eddyem/IR-controller/Documentation_rus/sisupr_short_descr_and_commands_TeX/pic/sisupr_front.jpg

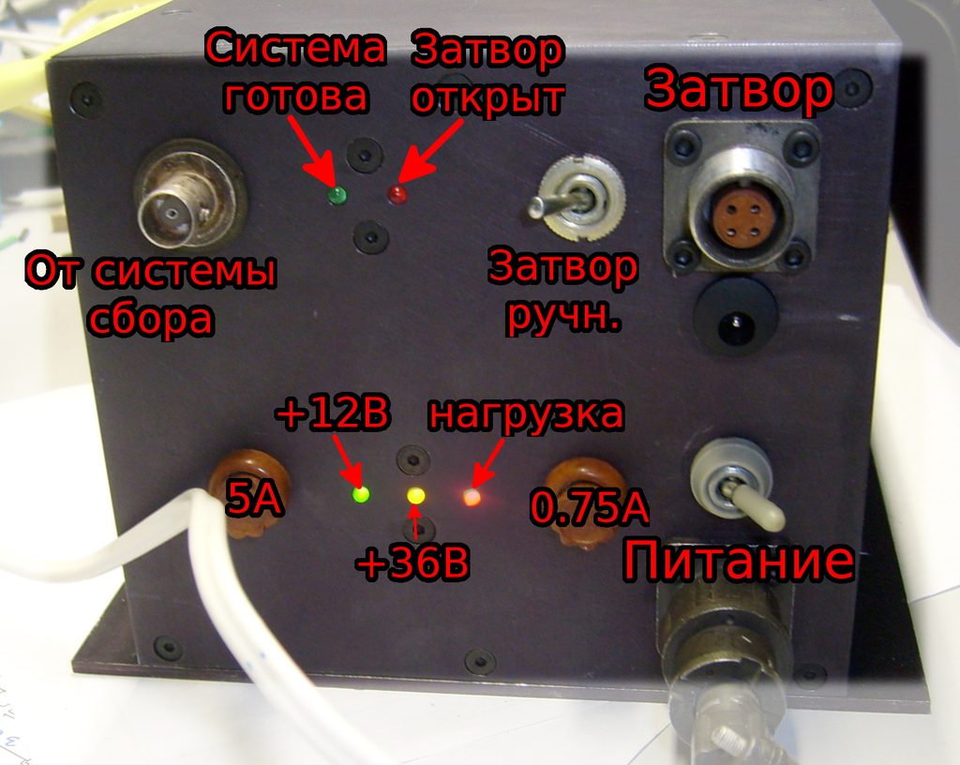
Documentation_rus/sisupr_short_descr_and_commands_TeX/pic/sisupr_front.jpg
