eddyem/IR-controller/README.md

IR-controller
=============

Clone of same project from sourceforge

Don't use files from root directory, they are obsolete!!! 
Current code is in directory with_opencm3.
