eddyem/IR-controller/schematic/ALL.pdf

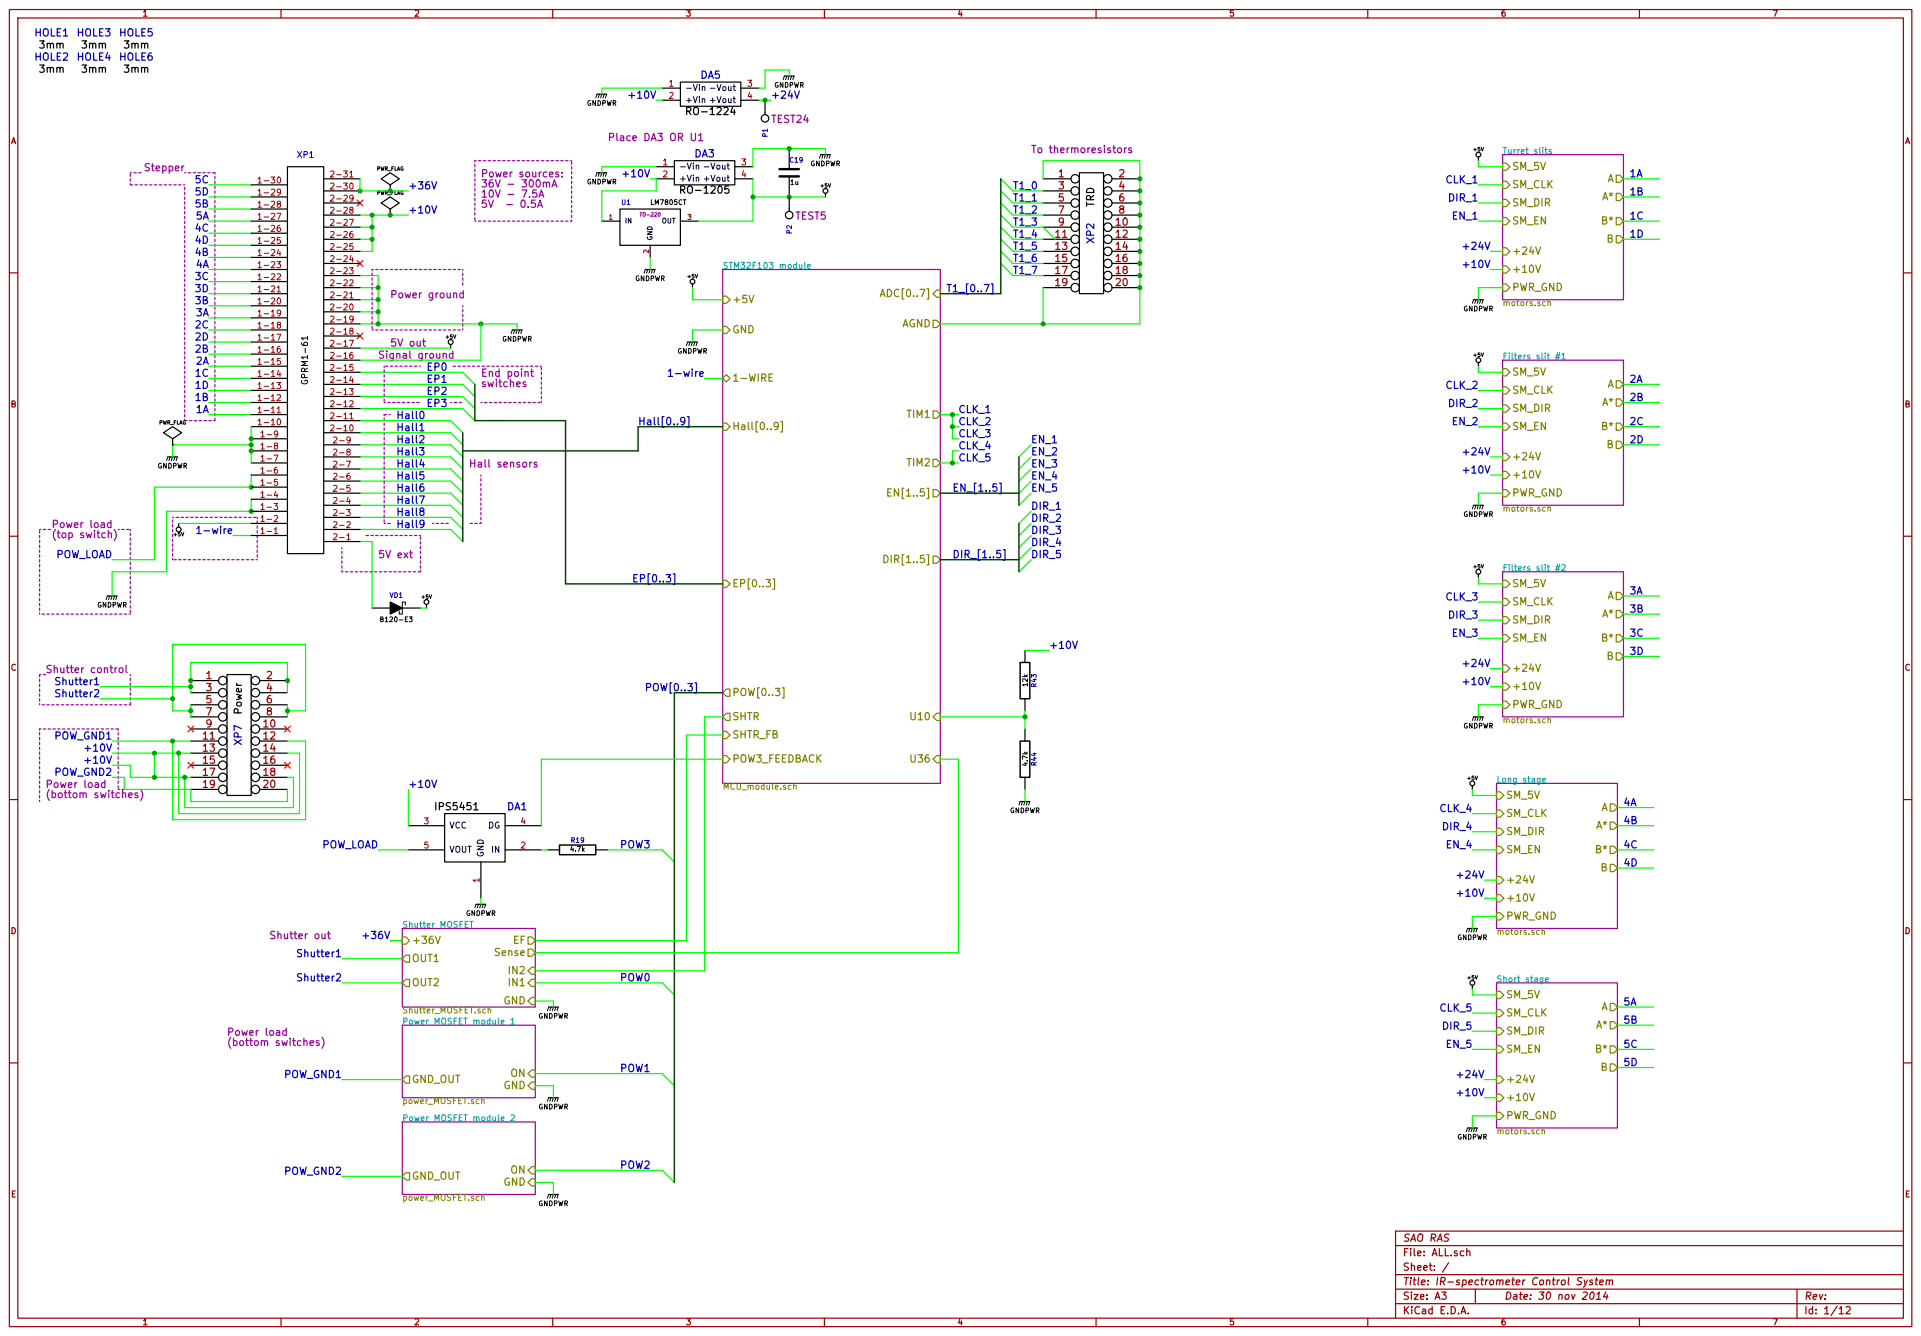
[picture p3: page 1]

Turret slits motors.sch SM_5V

Filters slit #1 motors.sch SM_5V
+5V +10V CLK_2

2-14
2-13

2-10
2-9
2-8
2-7
2-6
2-5
2-4
2-3

13 | | 14
15 | | 16

SAO RAS
File: ALL.sch Sheet: /

Title: IR-spectrometer Control System

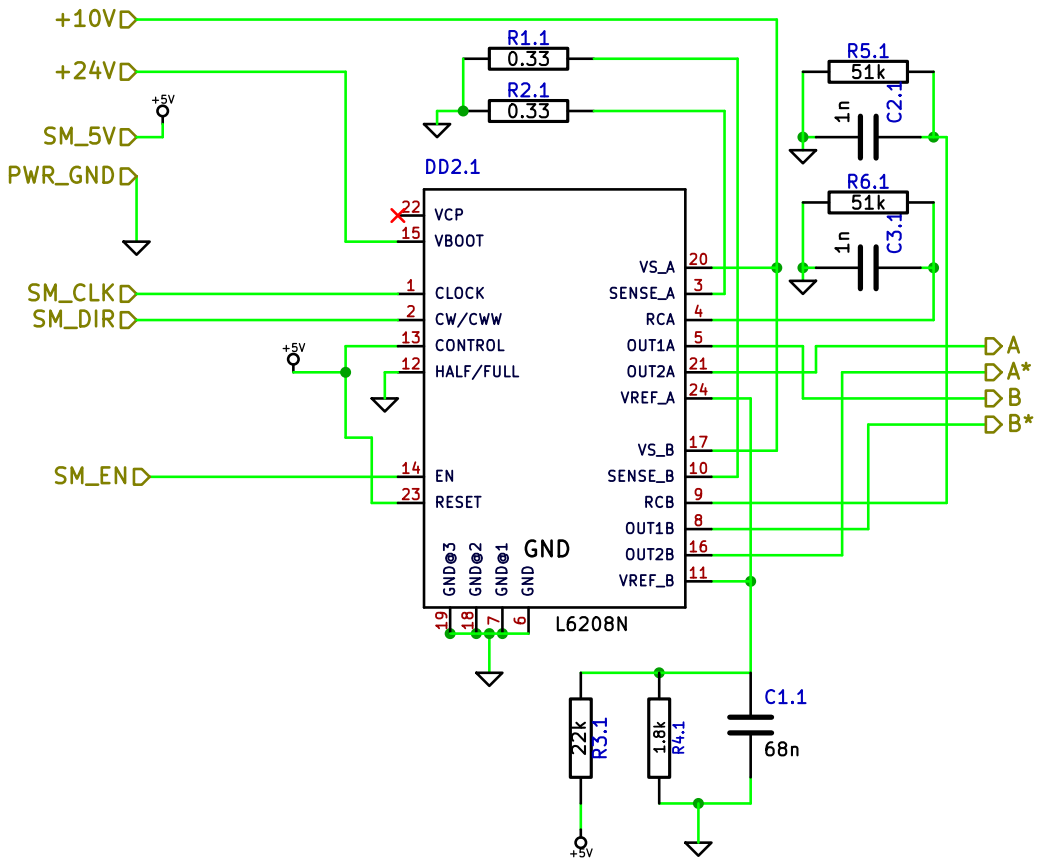
[picture p4: page 2]

7 OUT1B 8 RCB 9 SENSE_B 10 VS_A 20 VREF_B 11 OUT2A 21 HALF/FULL 12 VCP 22 CONTROL 13 RESET 23 EN 14 VREF_A 24 VBOOT 15 OUT2B 16 VS_B 17 GND@2 18 GND@3 19 DD2.1

Title: Stepper motor module File: motors.sch Sheet: /Turret slits/

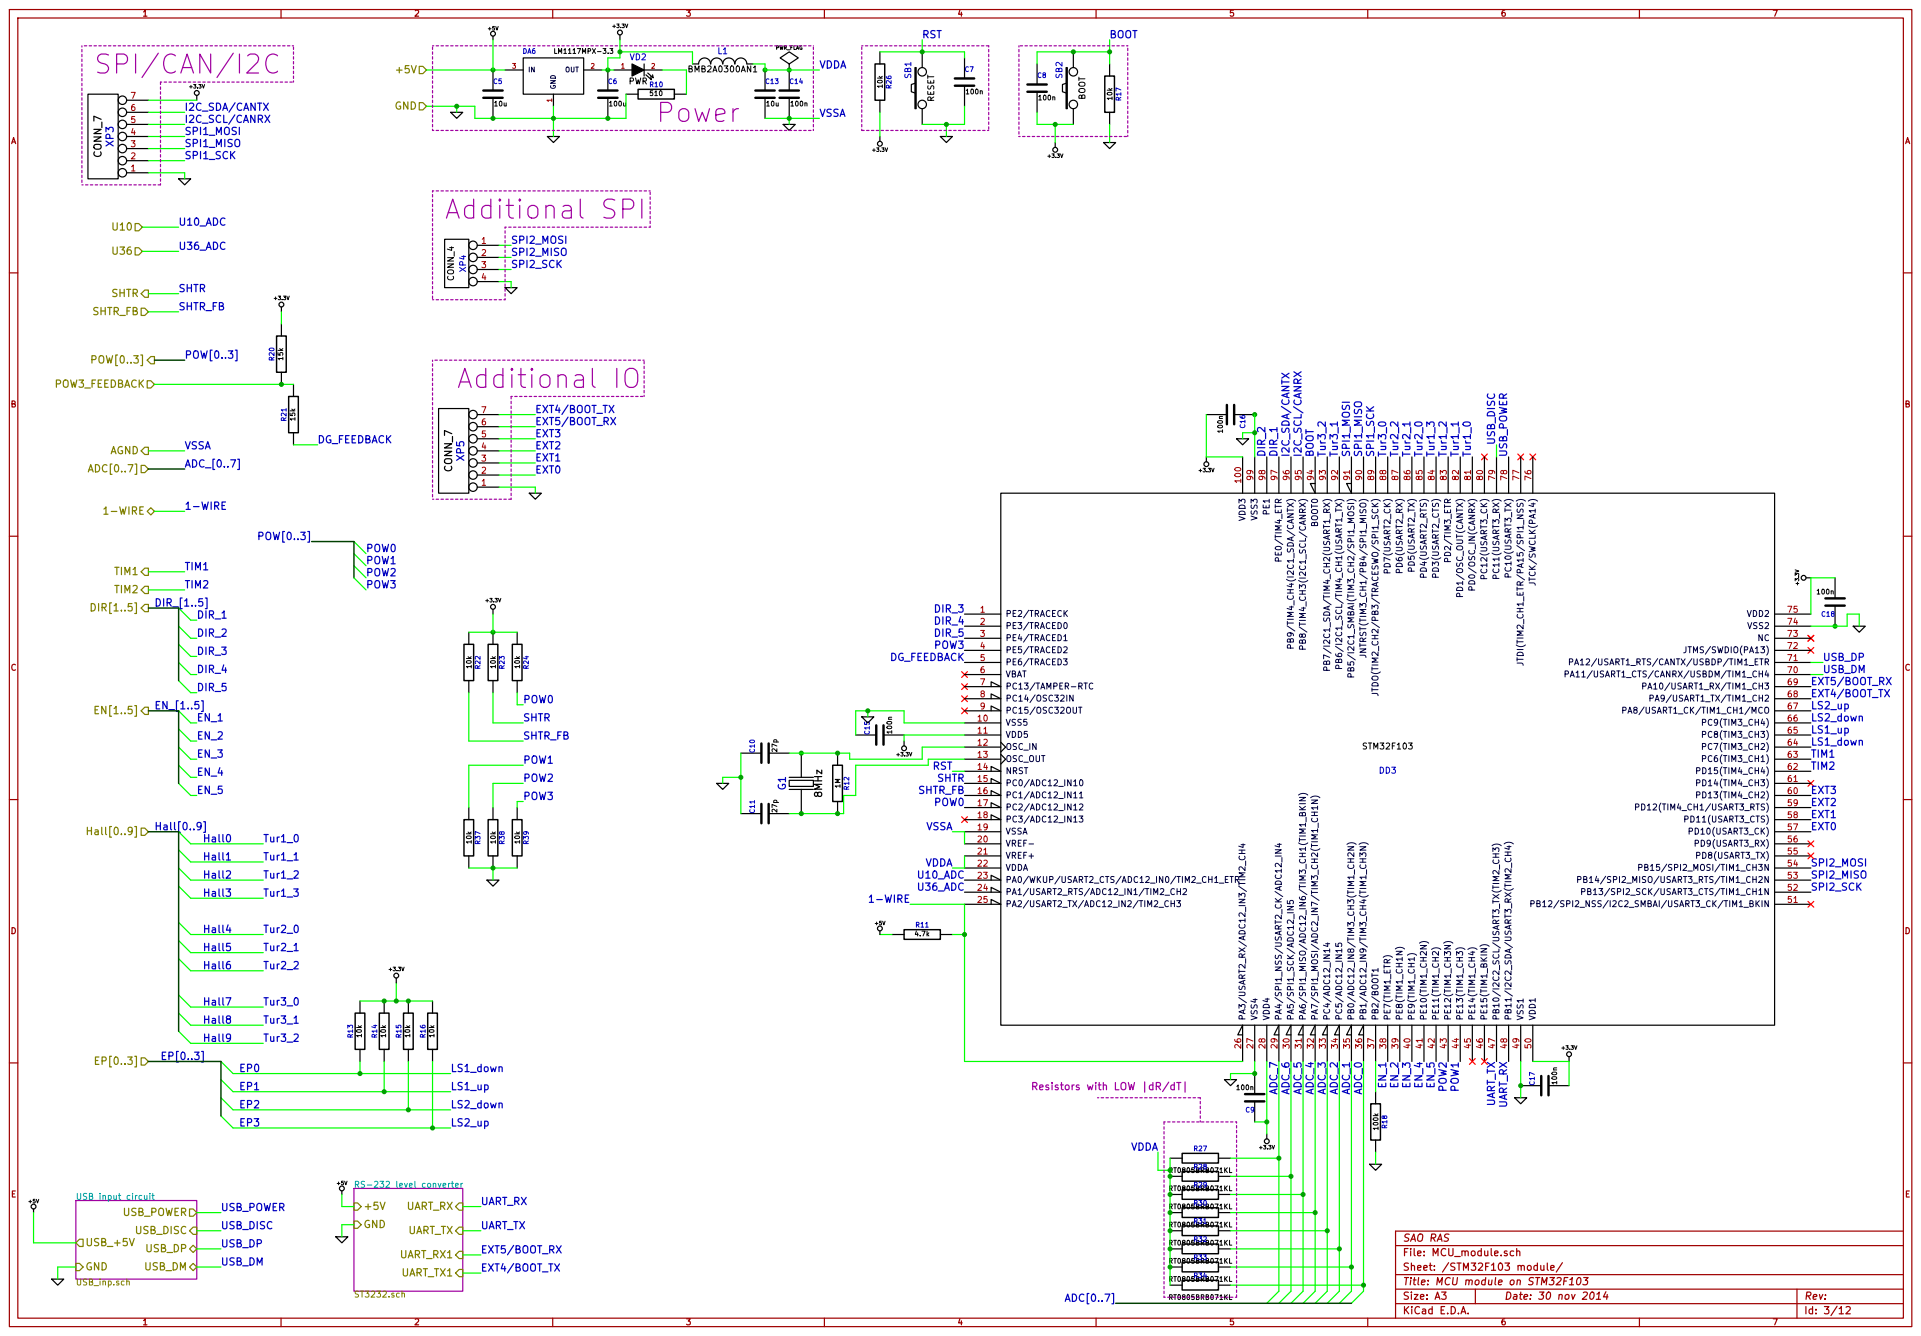
[picture p5: page 3]

RS-232 level converter ST3232.sch GND

SAO RAS
File: MCU_module.sch
Sheet: /STM32F103 module/
Title: MCU module on STM32F103

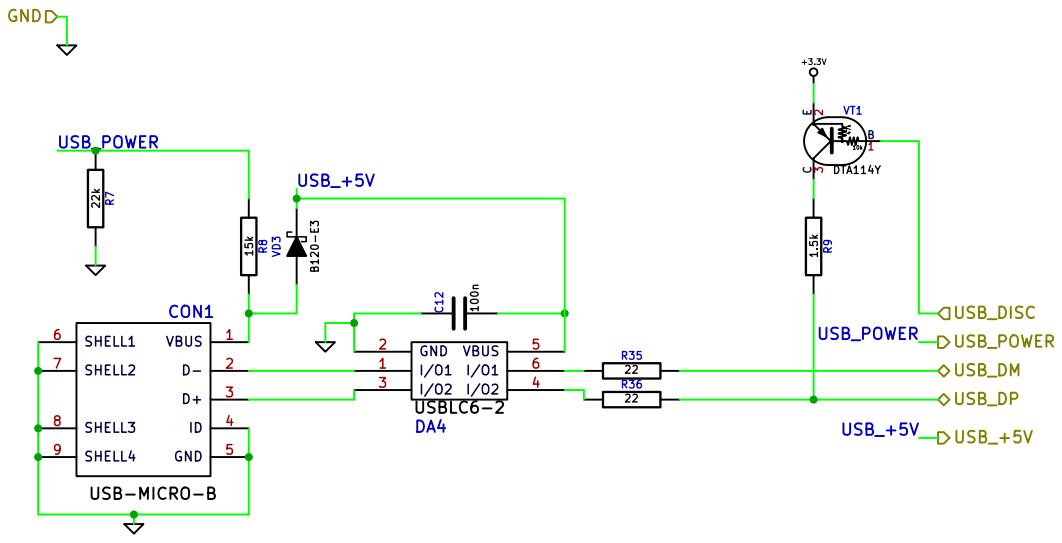
[picture p6: page 4]

SAO RAS
File: USB_inp.sch
Sheet: /STM32F103 module/USB input circuit/
Title: USB input circuit

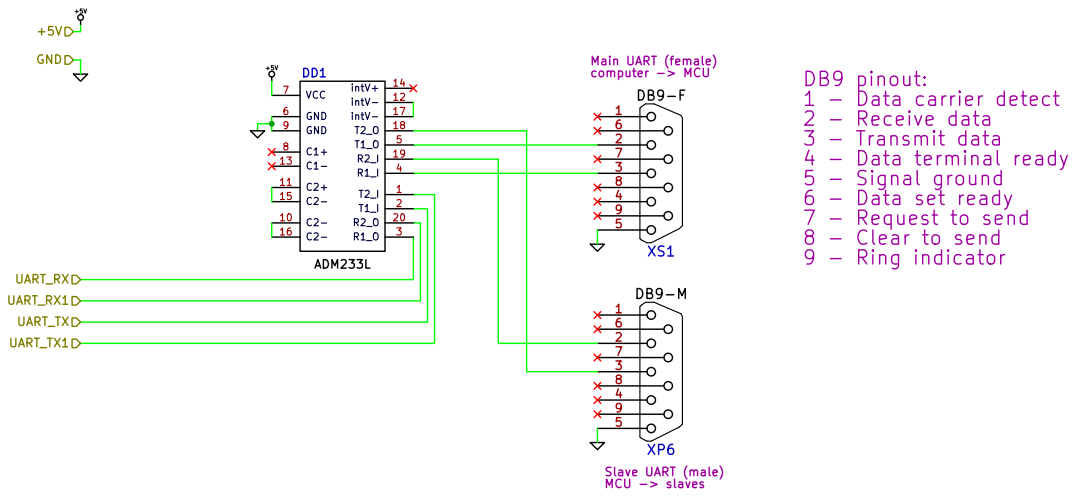
[picture p7: page 5]

SAO RAS
File: ST3232.sch
Sheet: /STM32F103 module/RS-232 level converter/
Title: RS-232 level converter

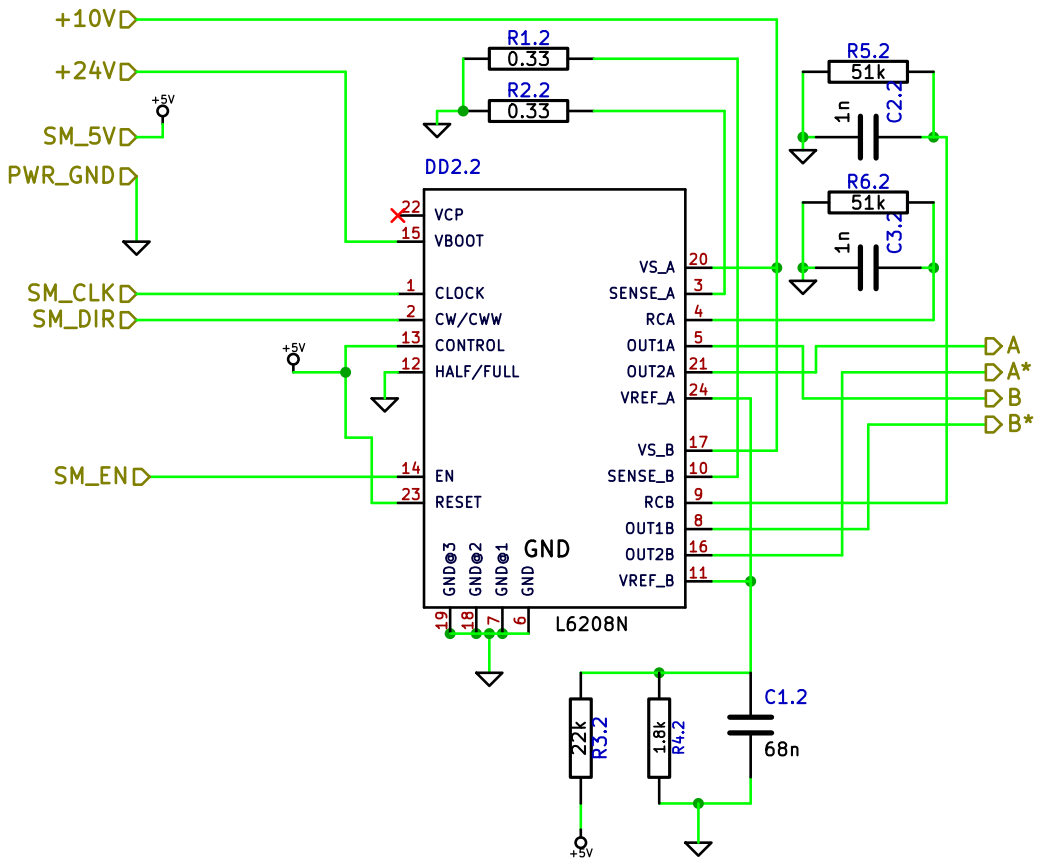
[picture p8: page 6]

7 OUT1B 8 RCB 9 SENSE_B 10 VS_A 20 VREF_B 11 OUT2A 21 HALF/FULL 12 VCP 22 CONTROL 13 RESET 23 EN 14 VREF_A 24 VBOOT 15 OUT2B 16 VS_B 17 GND@2 18 GND@3 19 DD2.2

Title: Stepper motor module File: motors.sch Sheet: /Filters slit #1/

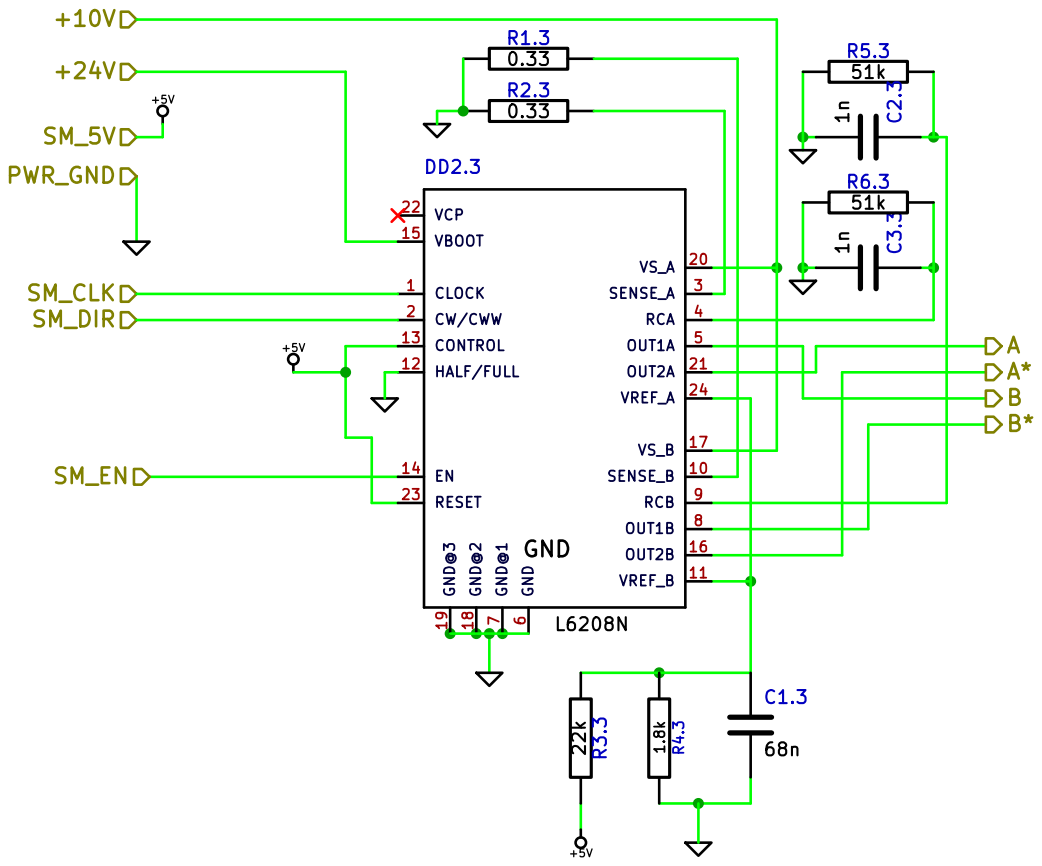
[picture p9: page 7]

7 OUT1B 8 RCB 9 SENSE_B 10 VS_A 20 VREF_B 11 OUT2A 21 HALF/FULL 12 VCP 22 CONTROL 13 RESET 23 EN 14 VREF_A 24 VBOOT 15 OUT2B 16 VS_B 17 GND@2 18 GND@3 19 DD2.3

Title: Stepper motor module File: motors.sch Sheet: /Filters slit #2/

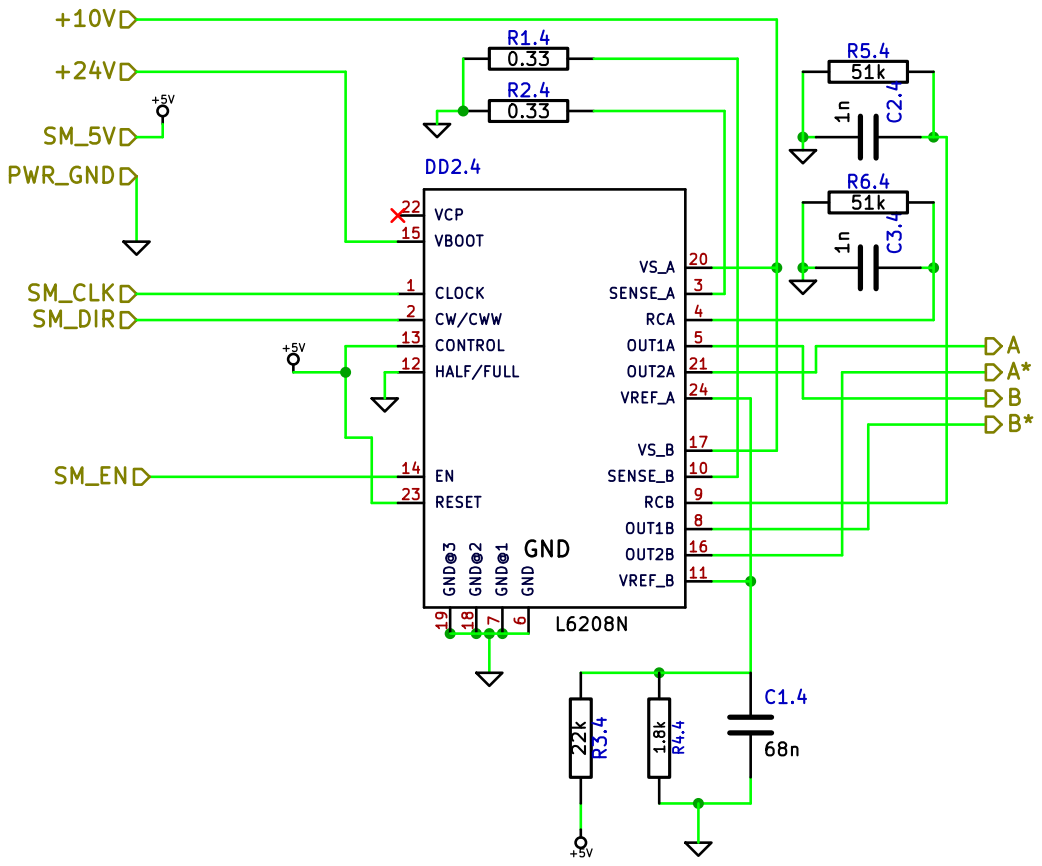
[picture p10: page 8]

7 OUT1B 8 RCB 9 SENSE_B 10 VS_A 20 VREF_B 11 OUT2A 21 HALF/FULL 12 VCP 22 CONTROL 13 RESET 23 EN 14 VREF_A 24 VBOOT 15 OUT2B 16 VS_B 17 GND@2 18 GND@3 19 DD2.4

Title: Stepper motor module File: motors.sch Sheet: /Long stage/

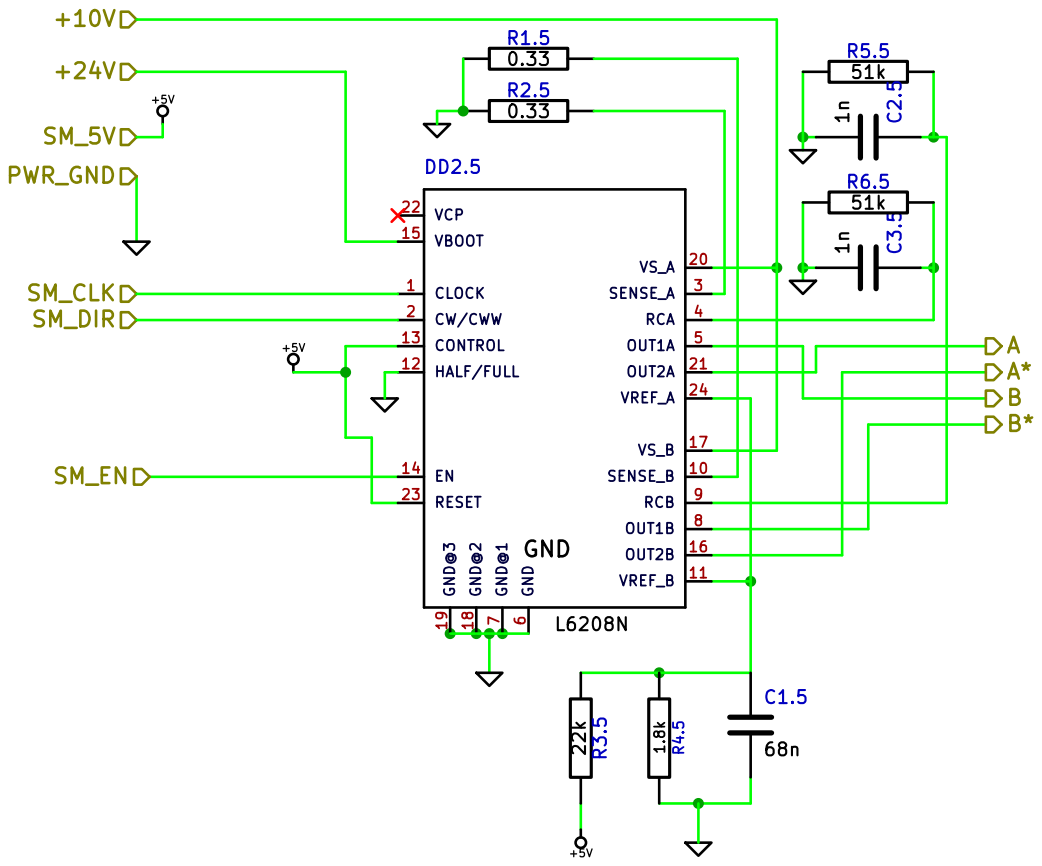
[picture p11: page 9]

7 OUT1B 8 RCB 9 SENSE_B 10 VS_A 20 VREF_B 11 OUT2A 21 HALF/FULL 12 VCP 22 CONTROL 13 RESET 23 EN 14 VREF_A 24 VBOOT 15 OUT2B 16 VS_B 17 GND@2 18 GND@3 19 DD2.5

Title: Stepper motor module File: motors.sch Sheet: /Short stage/

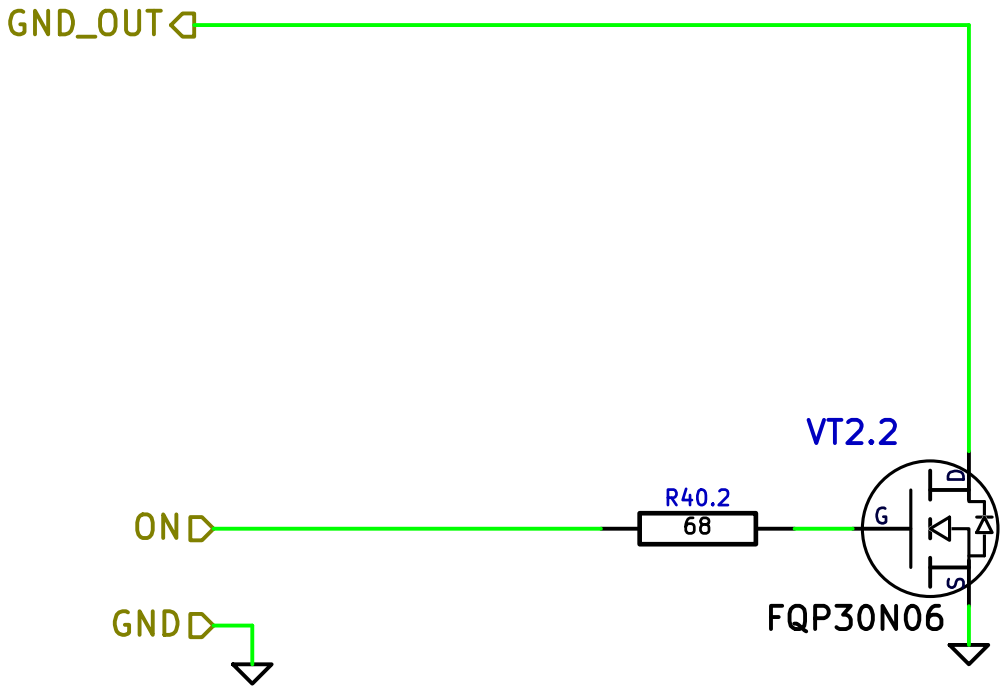
[picture p12: page 10]

SAO RAS
Id: 10/12 Title: Power load module File: power_MOSFET.sch
Sheet: /Power MOSFET module 1/

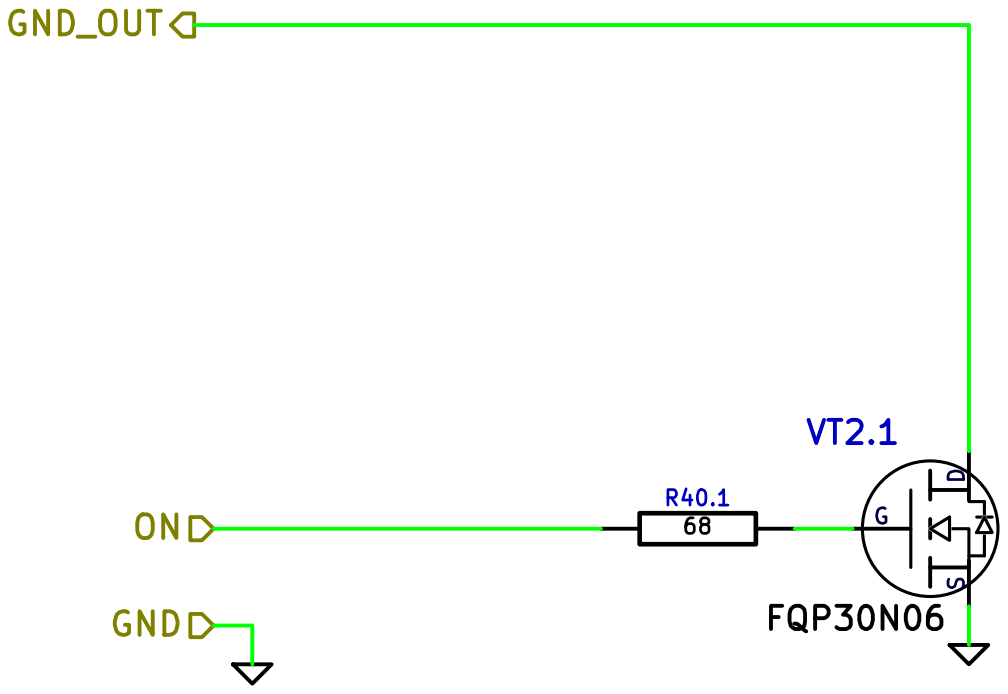
[picture p13: page 11]

SAO RAS
Id: 11/12 Title: Power load module File: power_MOSFET.sch
Sheet: /Power MOSFET module 2/

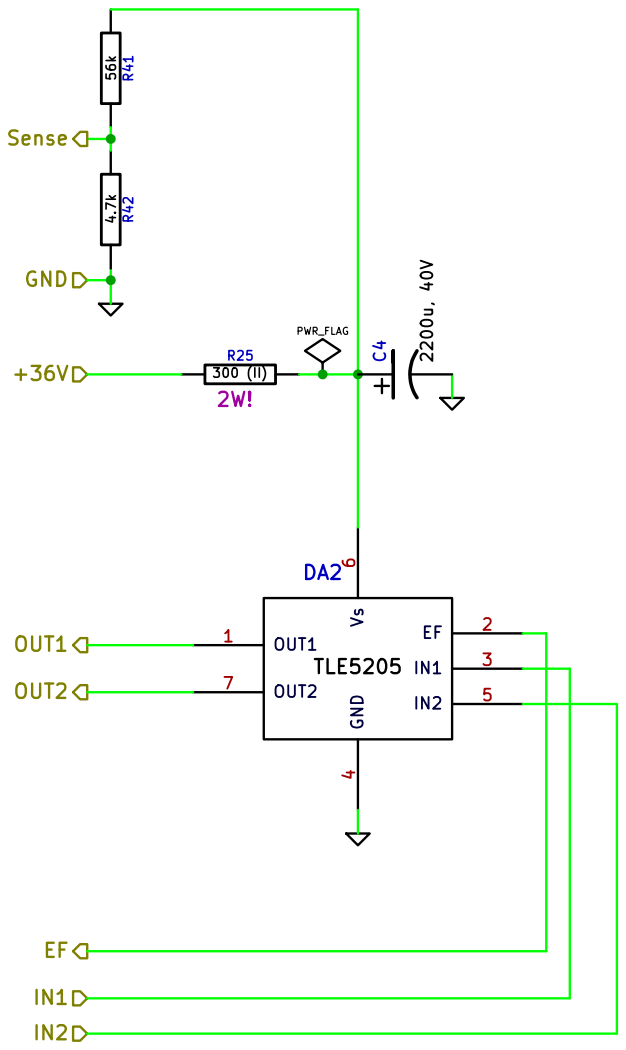
[picture p14: page 12]

SAO RAS
Id: 12/12 Title: Power load module File: Shutter_MOSFET.sch
Sheet: /Shutter MOSFET/
