eddyem/IR-controller/schematic/ALL.kicad_pcb

## KiCad design schematic/ALL.kicad_pcb (2014-07-09)

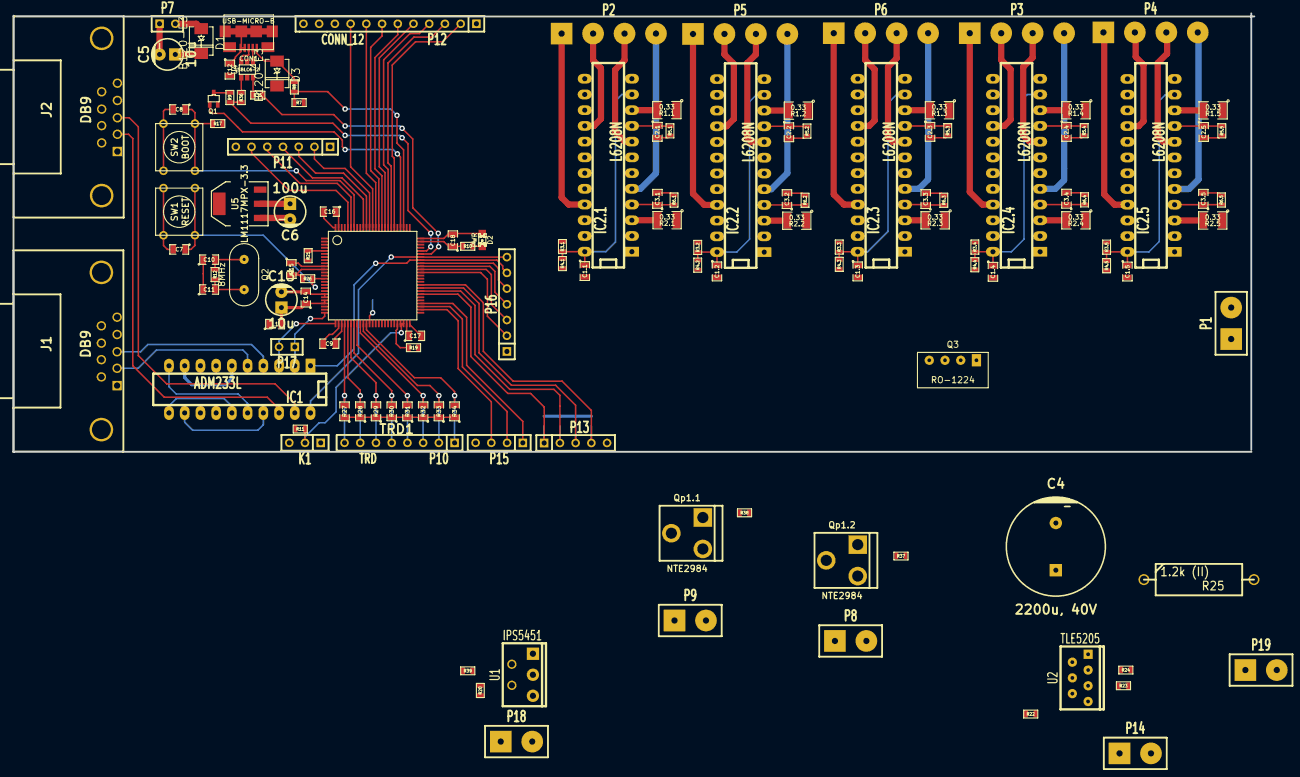
[picture p15: board ALL.kicad_pcb from above]

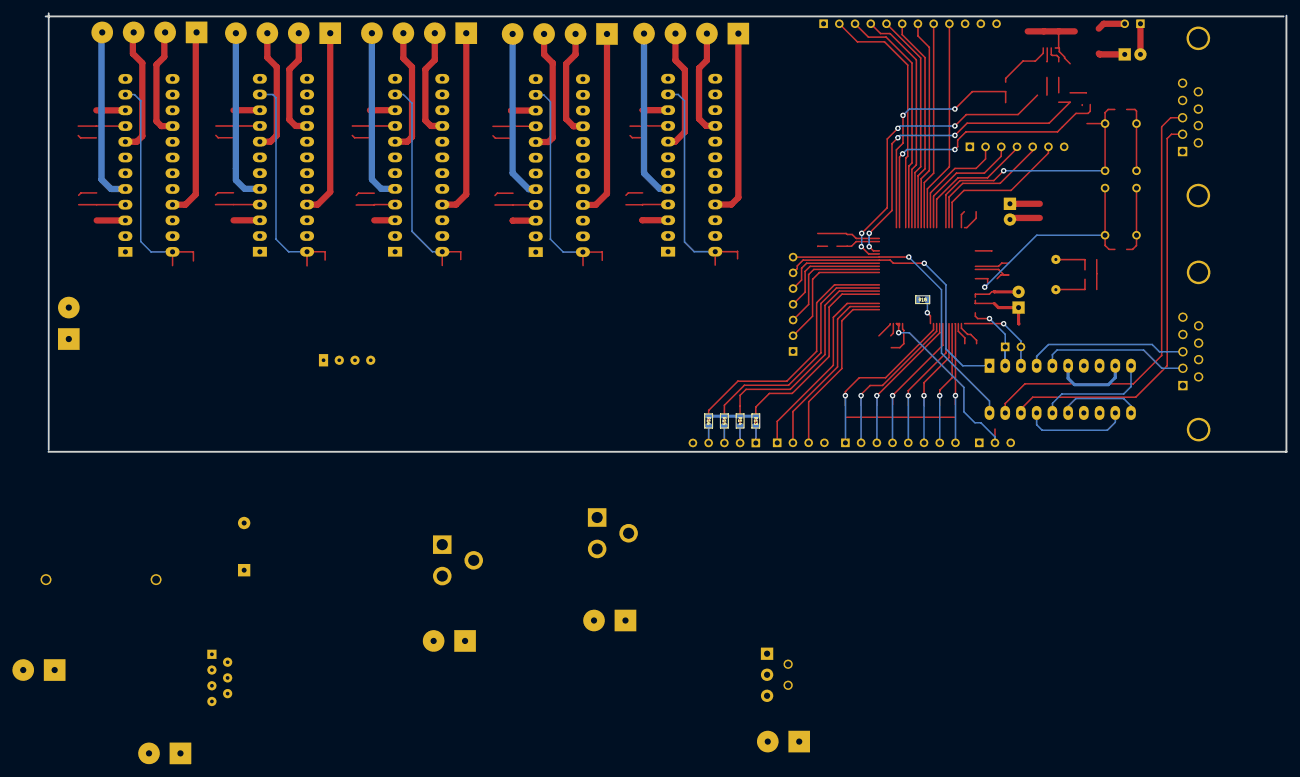
[picture p16: board ALL.kicad_pcb from below]

Board: 4 copper layers, 200.5 x 70.9 mm, 138 parts (5 on the bottom side), 142 nets.

Parts:
C1.1, C1.2, C1.3, C1.4, C1.5: 68n; SM0805
C2.1, C2.2, C2.3, C2.4, C2.5, C3.1, C3.2, C3.3, C3.4, C3.5: 1n; SM0805
C4: 2200u, 40V; CP_16x25mm
C5, C13: 10u; CP_5x11mm
C6: 100u; CP_5x11mm
C7, C8, C9, C12, C14, C15, C16, C17, C18: 100n; SM0805
C10, C11: 27p; SM0805
CON1: USB-MICRO-B; MICRO-B-USB
D1, D3: B120-E3; DO214
D2: PWR; LED-0805
IC1: ADM233L; DIP-20__300_ELL
IC2.1, IC2.2, IC2.3, IC2.4, IC2.5: L6208N; DIP-24__300_ELL
J1, J2: DB9; DB9FC
K1: CONN_3; SIL-3
L1: BMB2A0300AN1; SM0805
P1, P8, P9, P14, P18, P19: CONN_2; SIL-2-power
P2, P3, P4, P5, P6: CONN_4; SIL-4-power
P7, P17: CONN_2; SIL-2
P10: TRD; SIL-8
P11, P16: CONN_7; SIL-7
P12: CONN_12; SIL-12
P13: CONN_5; SIL-5
P15: CONN_4; SIL-4
Q1: DTA114Y; SOT323
Q2: 8MHz; hc49
Q3: RO-1224; SIP-4-RO
Qp1.1, Qp1.2: NTE2984; TO220-3-vert
R1.1, R1.2, R1.3, R1.4, R1.5, R2.1, R2.2, R2.3, R2.4, R2.5: 0.33; SM1210
R3.1, R3.2, R3.3, R3.4, R3.5, R7: 22k; SM0603
R4.1, R4.2, R4.3, R4.4, R4.5: 1.8k; SM0603
R5.1, R5.2, R5.3, R5.4, R5.5, R6.1, R6.2, R6.3, R6.4, R6.5: 51k; SM0603
R8, R20, R21: 15k; SM0603
R9: 1.5k; SM0603
R10: 510; SM0603
R11, R19: 4.7k; SM0603
R12: 1M; SM0603
R13, R14, R15, R16, R17, R22, R23, R24, R26, R37, R38, R39: 10k; SM0603
R18: 100k; SM0603
R25: 1.2k (II); R7
R27, R28, R29, R30, R31, R32, R33, R34: RT0805BRB071KL; SM0805
R35, R36: 22; SM0603
SW1: RESET; SW_PUSH_SMALL
SW2: BOOT; SW_PUSH_SMALL
U1: IPS5451; TO220-5
U2: TLE5205; TO220-7-12
U3: STM32F103; LQFP100_STM32
U4: USBLC6-2; SOT23_6
U5: LM1117MPX-3.3; SOT-223

Connections:
+3.3V: C6.1, C8.2, C9.1, C12.2, C15.2, C16.2, C17.2, C18.2, D2.1, L1.1, P11.7, Q1.2, R11.2, R20.2, R22.1, R23.1, R24.1, R26.2, SW2.1, U3.11, U3.28, U3.50, U3.75, U3.100, U4.5, U5.2
+5V: C5.1, D1.2, D3.2, IC1.7, IC2.1.13, IC2.1.23, IC2.2.13, IC2.2.23, IC2.3.13, IC2.3.23, IC2.4.13, IC2.4.23, IC2.5.13, IC2.5.23, K1.3, P12.1, R3.1.2, R3.2.2, R3.3.2, R3.4.2, R3.5.2, R13.2, R14.2, R15.2, R16.2, U5.3
/EP0: P13.1, R13.1, U3.57
/EP1: P13.2, R14.1, U3.58
/EP2: P13.3, R15.1, U3.59
/EP3: P13.4, R16.1, U3.60
/Filters slit #1/+10V: IC2.1.17, IC2.1.20, IC2.2.17, IC2.2.20, IC2.3.17, IC2.3.20, IC2.4.17, IC2.4.20, IC2.5.17, IC2.5.20, P1.2, P8.2, P9.2, Q3.1, U1.3
/Filters slit #1/+24V: IC2.1.15, IC2.2.15, IC2.3.15, IC2.4.15, IC2.5.15, Q3.3
/Filters slit #1/A: IC2.2.21, P5.1
/Filters slit #1/A*: IC2.2.16, P5.2
/Filters slit #1/B: IC2.2.5, P5.4
/Filters slit #1/B*: IC2.2.8, P5.3
/Filters slit #1/SM_CLK: IC2.1.1, IC2.2.1, IC2.3.1, U3.63
/Filters slit #1/SM_DIR: IC2.2.2, U3.98
/Filters slit #1/SM_EN: IC2.2.14, U3.39
/Filters slit #2/A: IC2.3.21, P6.1
/Filters slit #2/A*: IC2.3.16, P6.2
/Filters slit #2/B: IC2.3.5, P6.4
/Filters slit #2/B*: IC2.3.8, P6.3
/Filters slit #2/SM_DIR: IC2.3.2, U3.1
/Filters slit #2/SM_EN: IC2.3.14, U3.40
/Hall0: P12.2, U3.81
/Hall1: P12.3, U3.82
/Hall2: P12.4, U3.83
/Hall3: P12.5, U3.84
/Hall4: P12.6, U3.85
/Hall5: P12.7, U3.86
/Hall6: P12.8, U3.87
/Hall7: P12.9, U3.88
/Hall8: P12.10, U3.55
/Hall9: P12.11, U3.56
/Long stage/A: IC2.4.21, P3.1
/Long stage/A*: IC2.4.16, P3.2
/Long stage/B: IC2.4.5, P3.4
/Long stage/B*: IC2.4.8, P3.3
/Long stage/SM_CLK: IC2.4.1, IC2.5.1, U3.24
/Long stage/SM_DIR: IC2.4.2, U3.2
/Long stage/SM_EN: IC2.4.14, U3.41
/POW3: R19.2, R39.1, U3.46
/Power MOSFET module 1/GND_OUT: P8.1, Qp1.2.2
/Power MOSFET module 1/ON: Qp1.2.1, R37.1, U3.44
/Power MOSFET module 2/GND_OUT: P9.1, Qp1.1.2
/Power MOSFET module 2/ON: Qp1.1.1, R38.1, U3.45
/STM32F103 module/1-WIRE: K1.2, R11.1, U3.47, U3.48
/STM32F103 module/BOOT: C8.1, R17.1, SW2.2, U3.94
/STM32F103 module/DG_FEEDBACK: R21.1, U3.5
/STM32F103 module/EXT0: P16.2, U3.64
/STM32F103 module/EXT1: P16.3, U3.65
/STM32F103 module/EXT2: P16.4, U3.66
/STM32F103 module/EXT3: P16.5, U3.67
/STM32F103 module/I2C_SCL/CANRX: P11.5, U3.95
/STM32F103 module/I2C_SDA/CANTX: P11.6, U3.96
/STM32F103 module/RS-232 level converter/UART_RX: IC1.3, P17.2, U3.26
/STM32F103 module/RS-232 level converter/UART_RX1: IC1.20, P16.7, U3.69
/STM32F103 module/RS-232 level converter/UART_TX: IC1.2, P17.1, U3.25
/STM32F103 module/RS-232 level converter/UART_TX1: IC1.1, P16.6, U3.68
/STM32F103 module/RST: C7.1, R26.1, SW1.2, U3.14
/STM32F103 module/SHTR_FEEDBACK: R20.1, R21.2, U1.4
/STM32F103 module/SPI1_MISO: P11.3, U3.90
/STM32F103 module/SPI1_MOSI: P11.4, U3.91
/STM32F103 module/SPI1_SCK: P11.2, U3.89
/STM32F103 module/SPI2_MISO: P15.2, U3.53
/STM32F103 module/SPI2_MOSI: P15.1, U3.54
/STM32F103 module/SPI2_SCK: P15.3, U3.52
/STM32F103 module/USB input circuit/USB_DISC: Q1.1, U3.79
/STM32F103 module/USB input circuit/USB_DM: R35.2, U3.70
/STM32F103 module/USB input circuit/USB_DP: R9.2, R36.2, U3.71
/STM32F103 module/USB input circuit/USB_POWER: R7.1, R8.1, U3.78
/STM32F103 module/VDDA: C13.1, C14.1, L1.2, R27.1, R28.1, R29.1, R30.1, R31.1, R32.1, R33.1, R34.1, U3.21, U3.22
/Short stage/A: IC2.5.21, P4.1
/Short stage/A*: IC2.5.16, P4.2
/Short stage/B: IC2.5.5, P4.4
/Short stage/B*: IC2.5.8, P4.3
/Short stage/SM_DIR: IC2.5.2, U3.3
/Short stage/SM_EN: IC2.5.14, U3.42
/Shutter MOSFET/+36V: P19.2, R25.1
/Shutter MOSFET/EF: R22.2, U2.2, U3.16
/Shutter MOSFET/IN1: R24.2, U2.3, U3.43
/Shutter MOSFET/IN2: R23.2, U2.5, U3.15
/Shutter MOSFET/OUT1: P14.2, U2.1
/Shutter MOSFET/OUT2: P14.1, U2.7
/T1_0: P10.1, R34.2, U3.36
/T1_1: P10.2, R33.2, U3.35
/T1_2: P10.3, R32.2, U3.34
/T1_3: P10.4, R31.2, U3.33
/T1_4: P10.5, R30.2, U3.32
/T1_5: P10.6, R29.2, U3.31
/T1_6: P10.7, R28.2, U3.30
/T1_7: P10.8, R27.2, U3.29
/Turret slits/A: IC2.1.21, P2.1
/Turret slits/A*: IC2.1.16, P2.2
/Turret slits/B: IC2.1.5, P2.4
/Turret slits/B*: IC2.1.8, P2.3
/Turret slits/SM_DIR: IC2.1.2, U3.97
/Turret slits/SM_EN: IC2.1.14, U3.38
GND: C1.1.2, C1.2.2, C1.3.2, C1.4.2, C1.5.2, C2.1.2, C2.2.2, C2.3.2, C2.4.2, C2.5.2, C3.1.2, C3.2.2, C3.3.2, C3.4.2, C3.5.2, C4.2, C5.2, C6.2, C7.2, C9.2, C10.1, C11.1, C12.1, C13.2, C14.2, C15.1, C16.1, C17.1, C18.1, CON1.4, CON1.5, CON1.6, CON1.7, CON1.8, CON1.9, IC1.6, IC1.9, IC2.1.6, IC2.1.7, IC2.1.12, IC2.1.18, IC2.1.19, IC2.2.6, IC2.2.7, IC2.2.12, IC2.2.18, IC2.2.19, IC2.3.6, IC2.3.7, IC2.3.12, IC2.3.18, IC2.3.19, IC2.4.6, IC2.4.7, IC2.4.12, IC2.4.18, IC2.4.19, IC2.5.6, IC2.5.7, IC2.5.12, IC2.5.18, IC2.5.19, J1.5, J2.5, K1.1, P1.1, P7.1, P11.1, P12.12, P13.5, P15.4, P16.1, P18.1, P19.1, Q3.2, Q3.4, Qp1.1.3, Qp1.2.3, R1.1.1, R1.2.1, R1.3.1, R1.4.1, R1.5.1, R2.1.1, R2.2.1, R2.3.1, R2.4.1, R2.5.1, R4.1.2, R4.2.2, R4.3.2, R4.4.2, R4.5.2, R5.1.2, R5.2.2, R5.3.2, R5.4.2, R5.5.2, R6.1.2, R6.2.2, R6.3.2, R6.4.2, R6.5.2, R7.2, R10.1, R17.2, R18.2, R37.2, R38.2, R39.2, SW1.1, U1.1, U2.4, U3.10, U3.19, U3.20, U3.27, U3.49, U3.74, U3.99, U4.2, U5.1
unnamed: R19.1, U1.2
unnamed: P18.2, U1.5
unnamed: D1.1, P7.2
unnamed: C3.3.1, IC2.3.4, R6.3.1
unnamed: C2.3.1, IC2.3.9, R5.3.1
unnamed: IC2.3.3, R2.3.2
unnamed: IC2.3.10, R1.3.2
unnamed: C1.3.1, IC2.3.11, IC2.3.24, R3.3.1, R4.3.1
unnamed: R18.1, U3.37
unnamed: D2.2, R10.2
unnamed: C10.2, Q2.2, R12.1, U3.12
unnamed: C11.2, Q2.1, R12.2, U3.13
unnamed: C3.2.1, IC2.2.4, R6.2.1
unnamed: C2.2.1, IC2.2.9, R5.2.1
unnamed: IC2.2.3, R2.2.2
unnamed: IC2.2.10, R1.2.2
unnamed: C1.2.1, IC2.2.11, IC2.2.24, R3.2.1, R4.2.1
unnamed: C2.1.1, IC2.1.9, R5.1.1
unnamed: C1.1.1, IC2.1.11, IC2.1.24, R3.1.1, R4.1.1
unnamed: IC2.1.10, R1.1.2
unnamed: C3.1.1, IC2.1.4, R6.1.1
unnamed: IC2.1.3, R2.1.2
unnamed: IC2.5.10, R1.5.2
unnamed: C1.5.1, IC2.5.11, IC2.5.24, R3.5.1, R4.5.1
unnamed: C2.5.1, IC2.5.9, R5.5.1
unnamed: C3.5.1, IC2.5.4, R6.5.1
unnamed: IC2.5.3, R2.5.2
unnamed: IC2.4.3, R2.4.2
unnamed: IC2.4.10, R1.4.2
unnamed: C2.4.1, IC2.4.9, R5.4.1
unnamed: C3.4.1, IC2.4.4, R6.4.1
unnamed: C1.4.1, IC2.4.11, IC2.4.24, R3.4.1, R4.4.1
unnamed: C4.1, R25.2, U2.6
unnamed: IC1.5, J1.2
unnamed: IC1.4, J1.3
unnamed: IC1.12, IC1.17
unnamed: IC1.11, IC1.15
unnamed: IC1.10, IC1.16
unnamed: IC1.18, J2.2
unnamed: IC1.19, J2.3
unnamed: Q1.3, R9.1
unnamed: R36.1, U4.4
unnamed: R35.1, U4.6
unnamed: CON1.2, U4.1
unnamed: CON1.3, U4.3
unnamed: CON1.1, D3.1, R8.2
