eddyem/IR-controller/schematic/termo/termorez.kicad_pcb

## KiCad design schematic/termo/termorez.kicad_pcb (2015-05-14)

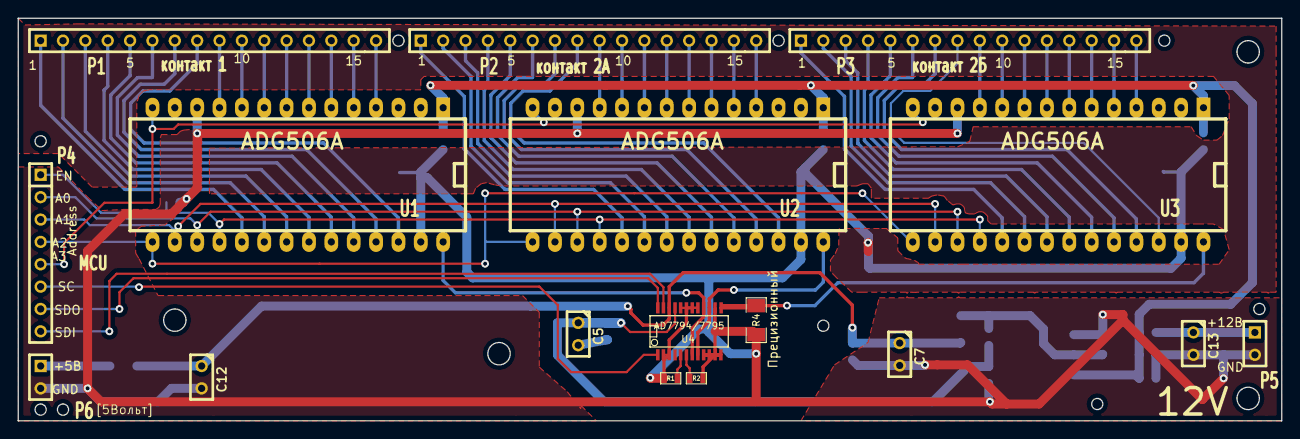
[picture p17: board schematic/termo/termorez.kicad_pcb from above]

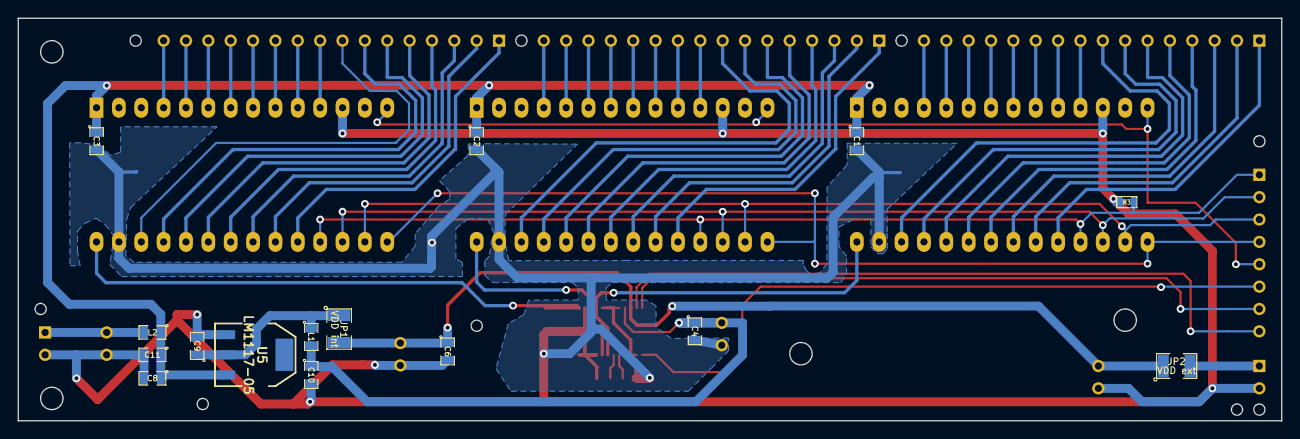
[picture p18: board schematic/termo/termorez.kicad_pcb from below]

Board: 2 copper layers, 143.5 x 45.7 mm, 32 parts (15 on the bottom side), 68 nets.

Parts:
C1, C2, C3, C4, C6, C9: 0.1u; SM0805
C5, C7, C12: 10u; C1
C8: 0.33u; SM0805
C10, C11: 1u; SM0805
C13: 100u; C1
JP1: VDD int; SM1210
JP2: VDD ext; SM1210
L1, L2: BMB2A0300AN1; SM0805
P1: контакт 1; SIL-16
P2: контакт 2А; SIL-16
P3: контакт 2Б; SIL-16
P4: MCU; SIL-8
P5: 12V; SIL-2
P6: 5Вольт; SIL-2
R1, R2: 10k; SM0603
R3: 47k; SM0603
R4: 5.1k PREC!; SM1206
U1, U2, U3: ADG506A; DIP-28__600_ELL
U4: AD7794/7795; SSOP24
U5: LM1117-05; SOT223

Connections:
+5VA: C4.1, C5.1, C10.1, L1.2, U4.21
+12V: C1.1, C2.1, C3.1, C8.1, C11.1, L2.1, U1.1, U2.1, U3.1, U5.3
+12Vex: C13.1, L2.2, P5.1
/A0: P4.2, U1.17, U2.17, U3.17
/A1: P4.3, U1.16, U2.16, U3.16
/A2: P4.4, U1.15, U2.15, U3.15
/A3: P4.5, U1.14, U2.14, U3.14
/EN: P4.1, R3.1, U1.18, U2.18, U3.18
/SC: P4.6, U4.1
/SDI: P4.8, U4.23
/SDO: P4.7, U4.24
DVDD: JP2.2, P6.1
GND: C1.2, C2.2, C3.2, C4.2, C5.2, C6.2, C7.2, C8.2, C9.2, C10.2, C11.2, C12.2, C13.2, P5.2, P6.2, R1.2, R2.2, R3.2, R4.2, U1.12, U1.27, U2.12, U2.27, U3.12, U3.27, U4.2, U4.3, U4.9, U4.10, U4.11, U4.12, U4.14, U4.17, U4.18, U4.19, U4.20, U5.1
unnamed: P1.3, U1.21
unnamed: P1.2, U1.20
unnamed: P1.1, U1.19
unnamed: P1.16, U1.4
unnamed: P1.15, U1.5
unnamed: P1.14, U1.6
unnamed: P1.13, U1.7
unnamed: P1.12, U1.8
unnamed: P1.11, U1.9
unnamed: P1.10, U1.10
unnamed: P1.9, U1.11
unnamed: P1.8, U1.26
unnamed: P1.7, U1.25
unnamed: P1.6, U1.24
unnamed: P1.5, U1.23
unnamed: P1.4, U1.22
unnamed: R2.1, U4.6
unnamed: P2.3, U2.21
unnamed: P2.2, U2.20
unnamed: P2.1, U2.19
unnamed: P2.16, U2.4
unnamed: P2.15, U2.5
unnamed: P2.14, U2.6
unnamed: P2.13, U2.7
unnamed: P2.12, U2.8
unnamed: P2.11, U2.9
unnamed: P2.10, U2.10
unnamed: P2.9, U2.11
unnamed: P2.8, U2.26
unnamed: P2.7, U2.25
unnamed: P2.6, U2.24
unnamed: P2.5, U2.23
unnamed: P2.4, U2.22
unnamed: R1.1, U4.5
unnamed: R4.1, U3.28, U4.13
unnamed: U1.28, U4.7, U4.16
unnamed: U2.28, U4.8, U4.15
unnamed: C9.1, JP1.1, L1.1, U5.2
unnamed: P3.3, U3.21
unnamed: P3.2, U3.20
unnamed: P3.1, U3.19
unnamed: P3.16, U3.4
unnamed: P3.15, U3.5
unnamed: P3.14, U3.6
unnamed: P3.13, U3.7
unnamed: P3.12, U3.8
unnamed: P3.11, U3.9
unnamed: P3.10, U3.10
unnamed: P3.9, U3.11
unnamed: P3.8, U3.26
unnamed: P3.7, U3.25
unnamed: P3.6, U3.24
unnamed: P3.5, U3.23
unnamed: P3.4, U3.22
VDD: C6.1, C7.1, C12.1, JP1.2, JP2.1, U4.22
