eddyem/IR-controller/schematic/termo-NX3L4051/termorez.kicad_pcb

## KiCad design schematic/termo-NX3L4051/termorez.kicad_pcb (2015-05-14)

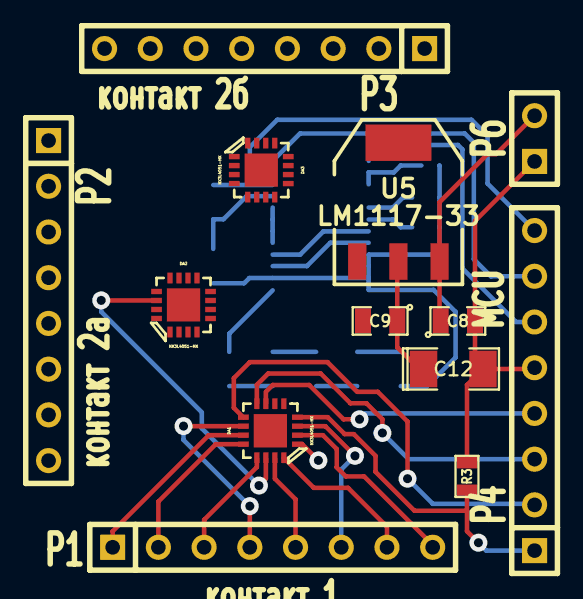
[picture p19: board schematic/termo-NX3L4051/termorez.kicad_pcb from above]

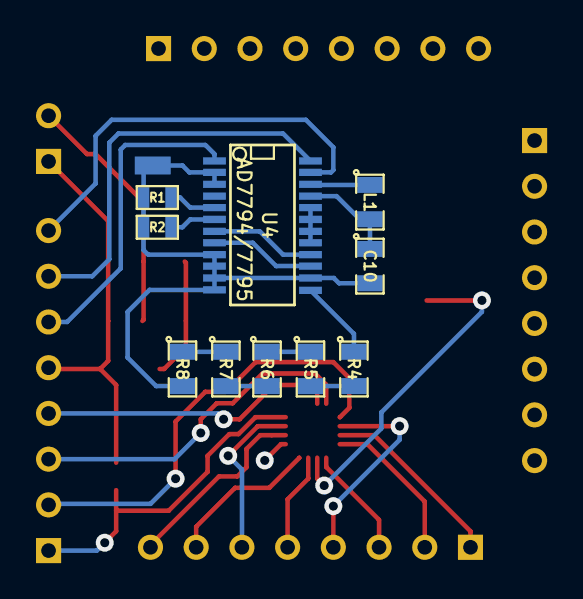
[picture p20: board schematic/termo-NX3L4051/termorez.kicad_pcb from below]

Board: 2 copper layers, 24 parts (11 on the bottom side), 45 nets.

Parts:
C8: 0.33u; SM0805
C9: 0.1u; SM0805
C10: 1u; SM0805
C12: 47u; SM1206POL
DA1, DA2, DA3: NX3L4051-HX; HXQFN16
L1: BMB2A0300AN1; SM0805
P1: контакт 1; SIL-8
P2: контакт 2a; SIL-8
P3: контакт 2б; SIL-8
P4: MCU; SIL-8
P6: 5V; SIL-2
R1, R2: 10k; SM0603
R3: 47k; SM0603
R4, R5, R6, R7, R8: 1k 0.1% (RT0805BRB071KL); SM0805
U4: AD7794/7795; SSOP24
U5: LM1117-33; SOT223
X1: GND_CONNECTOR; GND_connector

Connections:
+3.3V: C10.1, L1.2, U4.21
/A0: DA1.9, DA2.9, DA3.9, P4.2
/A1: DA1.8, DA2.8, DA3.8, P4.3
/A2: DA1.7, DA2.7, DA3.7, P4.4
/EN: DA1.4, DA2.4, DA3.4, P4.1, R3.1
/SC: P4.6, U4.1
/SDI: P4.8, U4.23
/SDO: P4.7, U4.24
AGND: C10.2, DA1.6, DA2.6, DA3.6, R1.2, R2.2, R8.2, U4.9, U4.10, U4.11, U4.12, U4.14, U4.17, U4.18, U4.19, U4.20, X1.2
DVDD: C8.1, P6.2, U5.3
GND: C8.2, C9.2, C12.2, P4.5, P6.1, R3.2, U4.2, U4.3, U5.1, X1.1
unnamed: DA1.1, U4.7, U4.16
unnamed: DA3.16, P3.7
unnamed: DA3.3, P3.6
unnamed: DA3.2, P3.8
unnamed: DA1.16, P1.7
unnamed: DA1.15, P1.5
unnamed: DA1.13, P1.3
unnamed: DA2.3, P2.6
unnamed: DA2.13, P2.3
unnamed: DA2.12, P2.2
unnamed: DA2.11, P2.1
unnamed: DA2.10, P2.4
unnamed: DA1.12, P1.2
unnamed: DA2.2, P2.8
unnamed: DA3.10, P3.4
unnamed: DA3.13, P3.3
unnamed: DA3.12, P3.2
unnamed: DA3.11, P3.1
unnamed: DA2.16, P2.7
unnamed: DA2.15, P2.5
unnamed: DA3.15, P3.5
unnamed: DA1.11, P1.1
unnamed: DA1.10, P1.4
unnamed: DA1.3, P1.6
unnamed: DA1.2, P1.8
unnamed: R4.2, R5.2
unnamed: R6.2, R7.2
unnamed: R5.1, R6.1
unnamed: R7.1, R8.1
unnamed: DA3.1, R4.1, U4.13
unnamed: DA2.1, U4.8, U4.15
unnamed: R2.1, U4.6
unnamed: R1.1, U4.5
VDD: C9.1, C12.1, DA1.14, DA2.14, DA3.14, L1.1, U4.22, U5.2
