eddyem/IR-controller/schematic/LEDs_in_box.kicad_pcb

## KiCad design schematic/LEDs_in_box.kicad_pcb (2015-04-22)

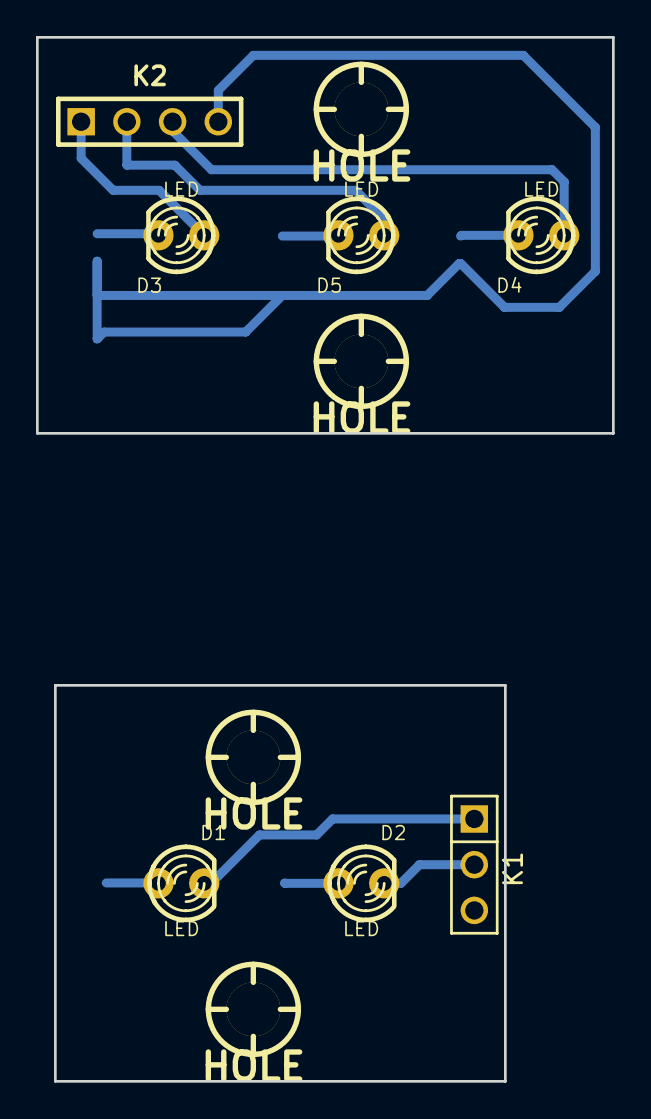
[picture p21: board LEDs_in_box.kicad_pcb from above]

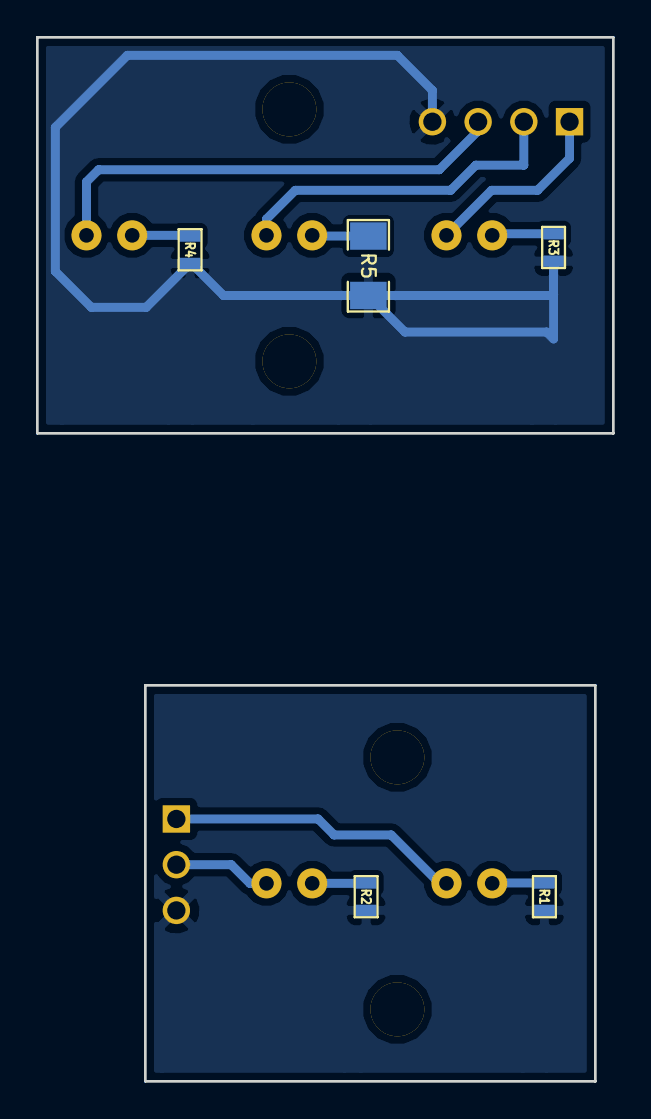
[picture p22: board LEDs_in_box.kicad_pcb from below]

Board: 2 copper layers, 32.0 x 58.0 mm, 16 parts (5 on the bottom side), 12 nets.

Parts:
D1, D2, D3, D4, D5: LED; LED-3MM
HOLE1, HOLE2, HOLE3, HOLE4: HOLE; hole_3mm
K1: CONN_3; PIN_ARRAY_3X1
K2: CONN_4; PIN_ARRAY_4x1
R1, R2: 330; SM0603
R3, R4: 2.2k; SM0603
R5: 6.8k; SM1206

Connections:
unnamed: D3.1, K2.1
unnamed: D4.1, K2.3
unnamed: D5.2, R5.2
unnamed: K2.4, R3.1, R4.1, R5.1
unnamed: D4.2, R4.2
unnamed: D3.2, R3.2
unnamed: D5.1, K2.2
unnamed: D1.1, R1.2
unnamed: D1.2, K1.1
unnamed: D2.2, K1.2
unnamed: K1.3, R1.1, R2.1
unnamed: D2.1, R2.2
