eddyem/IR-controller/with_opencm3/hardware_ini.h

/*
 * hardware_ini.h
 *
 * Copyright 2014 Edward V. Emelianov <eddy@sao.ru, edward.emelianoff@gmail.com>
 *
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
 * You should have received a copy of the GNU General Public License
 * along with this program; if not, write to the Free Software
 * Foundation, Inc., 51 Franklin Street, Fifth Floor, Boston,
 * MA 02110-1301, USA.
 */

#pragma once
#ifndef __HARDWARE_INI_H__
#define __HARDWARE_INI_H__


// to have a compatibility with medium-density devices we can use only timers 1..4!!!
/*
 * Timers:
 * SysTick - system time
 * TIM1 - not used
 * TIM2 - 1-wire
 * TIM3, TIM4 - stepper motors
 */


extern volatile uint16_t ADC_value[]; // ADC DMA value

#define TRD_NO			(8) // number of TRD devices
// bits used to address external SPI ADC - PD10..12
#define ADC_ADDR_MASK	(GPIO10|GPIO11|GPIO12)
#define ADC_SET_ADDR(X)	((X << 10) & ADC_ADDR_MASK)
#define ADC_EN_PIN		GPIO13
#define ADC_ADDR_PORT	GPIOD

void SPI1_init();
void SPI2_init();
void GPIO_init();
void SysTick_init();
void ADC_init();
void ADC_calibrate_and_start();

void adc_dma_on();

/*
 * USB interface
 */
// USB_DICS (disconnect) - PC11
#define USB_DISC_PIN		GPIO11
#define USB_DISC_PORT		GPIOC
// USB_POWER (high level when USB connected to PC)
#define USB_POWER_PIN		GPIO10
#define USB_POWER_PORT		GPIOC
// change signal level on USB diconnect pin
#define usb_disc_high()   gpio_set(USB_DISC_PORT, USB_DISC_PIN)
#define usb_disc_low()    gpio_clear(USB_DISC_PORT, USB_DISC_PIN)
// in case of n-channel FET on 1.5k pull-up change on/off disconnect means low level
// in case of pnp bipolar transistor or p-channel FET on 1.5k pull-up disconnect means high level
#define usb_disconnect()  usb_disc_high()
#define usb_connect()     usb_disc_low()

/*
 * Stepper motors
 * motors' interface use timers 1 & 2, so even hardware-dependent functions are
 * 		moved to stepper_motors.c
 */
// PE7..11 - EN
#define MOTOR_EN_MASK		(0x1f << 7)
#define MOTOR_EN_PORT		(GPIOE)
// N == 0..4
#define MOTOR_EN_PIN(N)		(GPIO7 << (N))
// PE0..PE5 - DIR
#define MOTOR_DIR_MASK		(0x1f)
#define MOTOR_DIR_PORT		(GPIOE)
// N == 0..4
#define MOTOR_DIR_PIN(N)	(GPIO0 << (N))
// timers: TIM1 - PC6, TIM2 - PD15
#define MOTOR_TIM1_PORT		(GPIOC)
#define MOTOR_TIM1_PIN		(GPIO6)
#define MOTOR_TIM2_PORT		(GPIOD)
#define MOTOR_TIM2_PIN		(GPIO15)
// don't even try to move motor if motors' voltage less than 9.0V
#define MOTORS_VOLTAGE_THRES  (900)
// stop all motors if voltage less than 7.5V
#define MOTORS_VOLTAGE_ALERT  (750)

/*
 * One Wire interface
 *
// In case of using other USART for 1-wire port, make corresponding change
// and redefine pins in OW_Init
#define OW_USART_X			USART2
#define OW_RX_PORT			GPIO_BANK_USART2_RX
#define OW_RX_PIN			GPIO_USART2_RX
*/
/*
 * Shutter defines
 */
// external signals for shutter opening: PB3 (SPI1_SCK) - from camera electronics, PB4 (SPI1_MISO) - from manual switch
// both are pull-up inputs
//#define SHUTTER_CAM_PORT	(GPIOB)
//#define SHUTTER_CAM_PIN		(GPIO3)
// As PB3 was burned, redefine CAM to EXT0 - PD10
#define SHUTTER_CAM_PORT	(GPIOD)
#define SHUTTER_CAM_PIN		(GPIO10)
#define SHUTTER_MAN_PORT	(GPIOB)
#define SHUTTER_MAN_PIN		(GPIO4)
// shutter feedback ==0 when opened, PB5 (SPI1_MOSI)
#define SHUTTER_FBSW_PORT	(GPIOB)
#define SHUTTER_FBSW_PIN	(GPIO5)
// LED status open-drain output: PB8 (CAN RX)
#define LED_STATUS_PORT		(GPIOB)
#define LED_STATUS_PIN		(GPIO8)
#define LED_STATUS_OK()		do{gpio_clear(LED_STATUS_PORT, LED_STATUS_PIN);}while(0)
#define LED_STATUS_BAD()	do{gpio_set(LED_STATUS_PORT, LED_STATUS_PIN);}while(0)
// Shutter LED (lights when shutter opened) open-drain output, PB9 (CAN TX)
#define LED_SHUTTER_PORT	(GPIOB)
#define LED_SHUTTER_PIN		(GPIO9)
#define LED_SHUTTER_OPEN()	do{gpio_clear(LED_SHUTTER_PORT, LED_SHUTTER_PIN);}while(0)
#define LED_SHUTTER_CLOSE()	do{gpio_set(LED_SHUTTER_PORT, LED_SHUTTER_PIN);}while(0)

// Shutter pins: PC0 & PC2 are polarity & on/off pins; PC1 is feedback pin
#define SHUTTER_PORT           (GPIOC)
#define SHUTTER_ON_PIN         (GPIO2)
#define SHUTTER_POLARITY_PIN   (GPIO0)
#define SHUTTER_FB_PIN         (GPIO1)
// voltage (*100) threshold to run shutter - 20V
#define SHUTTER_VOLTAGE_THRES  (2000)
// minimum voltage that should be on capasitor if power source is on
#define SHUTTER_UNDERVOLTAGE_THRES  (700)
// delay in operations (open/close) in milliseconds (according to shutter's datasheet it's about 12ms -> make 15)
#define SHUTTER_DELAY  (15)
// delay for error test (in microseconds)
#define SHUTTER_OP_DELAY (200)

// ADC_value[8] is U36, ADC_value[9] is U10
#define SHUTTER_SENSE_NUMBER  (8)
#define POWER_SENSE_NUMBER    (9)
int shutter_voltage();
int power_voltage();
int TRD_value(uint8_t num);

#endif // __HARDWARE_INI_H__
