eddyem/IR-controller/(commit log)

2014-07-09 added schematic
    [ALL.kicad_pcb, ALL.sch, MCU_module.sch, ST3232.sch, Shutter_MOSFET.sch, USB_inp.sch, motors.sch, motors_b.sch]
2014-07-24 Added one channel ADC through DMA
2014-09-23 fixed bug with USB buffer lost
    [cdcacm.c]
2014-09-29 1st try to fix errors on PCB
    [ALL.kicad_pcb, ALL.sch, MCU_module.sch, ST3232.sch, Shutter_MOSFET.sch, USB_inp.sch, motors.sch, power_MOSFET.sch]
2014-10-30 try to make 1-wire on timers
    [ALL.sch, MCU_module.sch, ST3232.sch, Shutter_MOSFET.sch, USB_inp.sch, motors.sch, power_MOSFET.sch]
2014-12-02 modified schematics
    [ALL.kicad_pcb, ALL.sch, MCU_module.sch, ST3232.sch, Shutter_MOSFET.sch, USB_inp.sch, motors.sch, power_MOSFET.sch]
2015-01-27 Add something to stepper_motors.c + make little modifications
    [ALL.kicad_pcb]
2015-02-03 some modifications, shutter not work :(
    [ALL.sch, MCU_module.sch, ST3232.sch, Shutter_MOSFET.sch, USB_inp.sch, motors.sch, power_MOSFET.sch]
2015-02-04 Shutter module tested
    [ALL.sch, MCU_module.sch, ST3232.sch, Shutter_MOSFET.sch, USB_inp.sch, motors.sch, power_MOSFET.sch]
2015-02-06 fixed errors in flash write module
    [flash.c, flash.h, hardware_ini.c, main.c, main.h, user_proto.c]
2015-04-17 A lot of errors fixed
    [flash.c, flash.h, hardware_ini.c, hardware_ini.h, main.c, powerhw.c, powerhw.h, stepper_motors.c]
2015-04-22 Steppers worked & tested; inner ADC works fine; add median filtering by 9 points for TRD resistance values
2015-04-22 make some cleanup
    [LEDs_in_box.kicad_pcb, LEDs_in_box.sch]
2015-05-14 Fixed bugs when work in mustdie's terminal
    [ALL.kicad_pcb, ALL.sch, MCU_module.sch, ST3232.sch, Shutter_MOSFET.sch, USB_inp.sch, motors.sch, power_MOSFET.sch]
2015-07-28 added 1-wire support
2015-08-04 add init on poweron
2016-04-21 fix error in 1-wire data conversion for DS18B20
    [onewire.c]
2023-08-08 save under new kicad
    [ALL.kicad_pcb]
